AaronMichaelMendoza/Running-Watch/running watch flyer.png

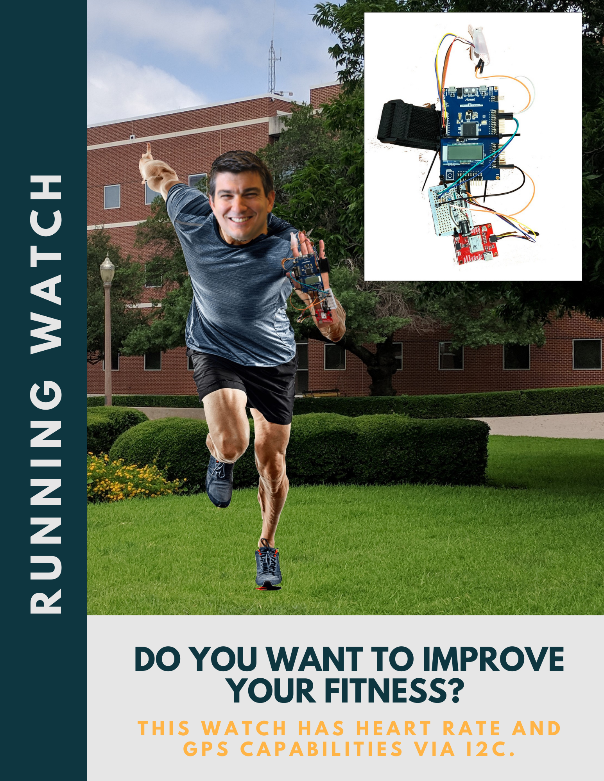
running watch flyer.png
