AaronMichaelMendoza/Running-Watch/Design/Final Project - Activity Diagram for Main.pdf

## Main

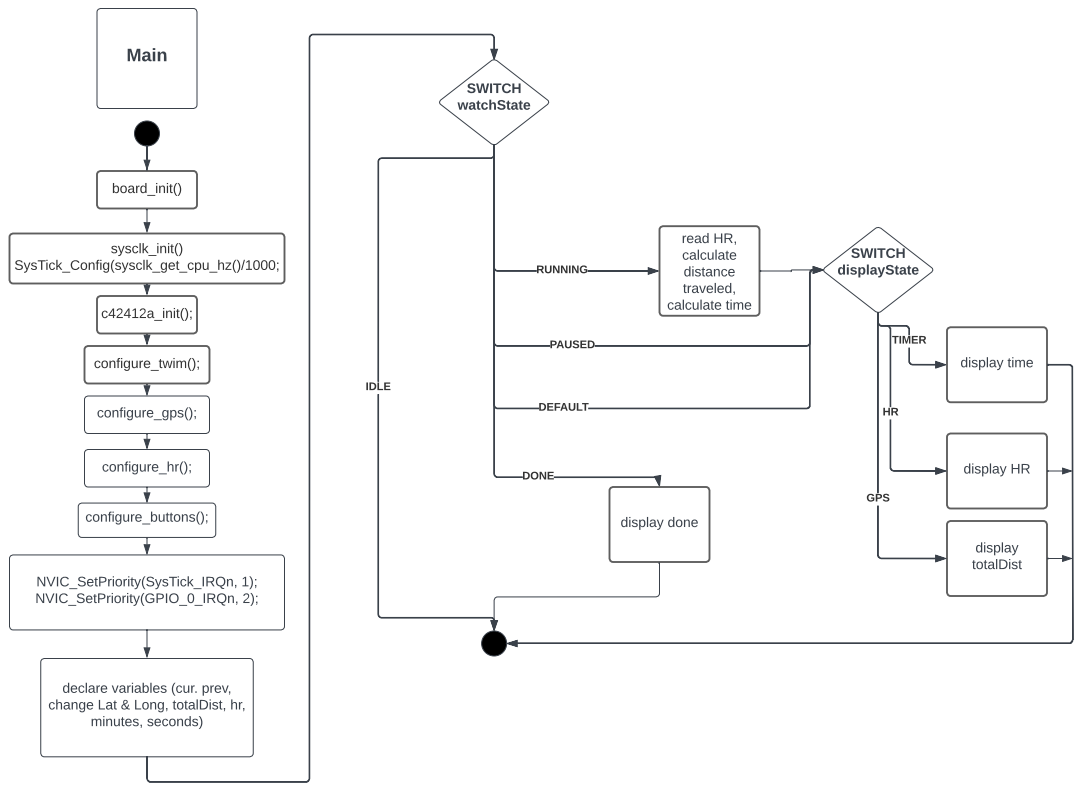
[picture p18: page 1]
configure_gps();; configure_hr();; board_init(); sysclk_init() SysTick_Config(sysclk_get_cpu_hz()/1000;; NVIC_SetPriority(SysTick_IRQn, 1); NVIC_SetPriority(GPIO_0_IRQn, 2);; c42412a_init();; configure_twim();; configure_buttons();; SWITCH watchState; IDLE; RUNNING; PAUSED; read HR, calculate distance traveled, calculate time; DONE; DEFAULT; SWITCH displayState; TIMER; display time; display HR; display totalDist; GPS; display done

declare variables (cur. prev,
change Lat & Long, totalDist, hr, minutes, seconds)
