AaronMichaelMendoza/Running-Watch/Design/Final Project - Block Diagram.pdf

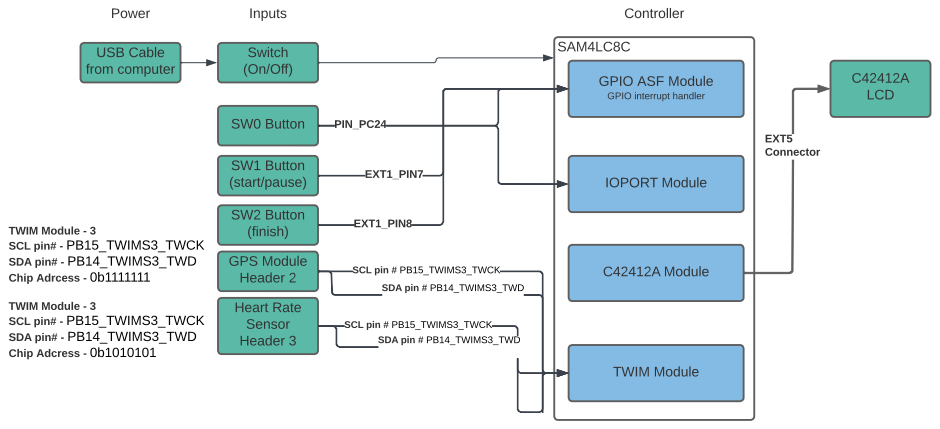
[picture p19: page 1]
Inputs; GPS Module Header 2; Heart Rate Sensor Header 3; SW0 Button; SW2 Button (finish); SW1 Button (start/pause); Switch (On/Off); Power; USB Cable from computer; Controller; SAM4LC8C; IOPORT Module; C42412A Module; TWIM Module; C42412A LCD; EXT5 Connector; PIN_PC24; EXT1_PIN7; EXT1_PIN8; TWIM Module - 3 SCL pin# - PB15_TWIMS3_TWCK SDA pin# - PB14_TWIMS3_TWD Chip Adcress - 0b1010101; TWIM Module - 3 SCL pin# - PB15_TWIMS3_TWCK SDA pin# - PB14_TWIMS3_TWD Chip Adrcess - 0b1111111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

GPIO ASF Module
GPIO interrupt handler
