AaronMichaelMendoza/Running-Watch/Design/Final Project - Callback Activity Diagrams.pdf

## button1_callback

## button2_callback

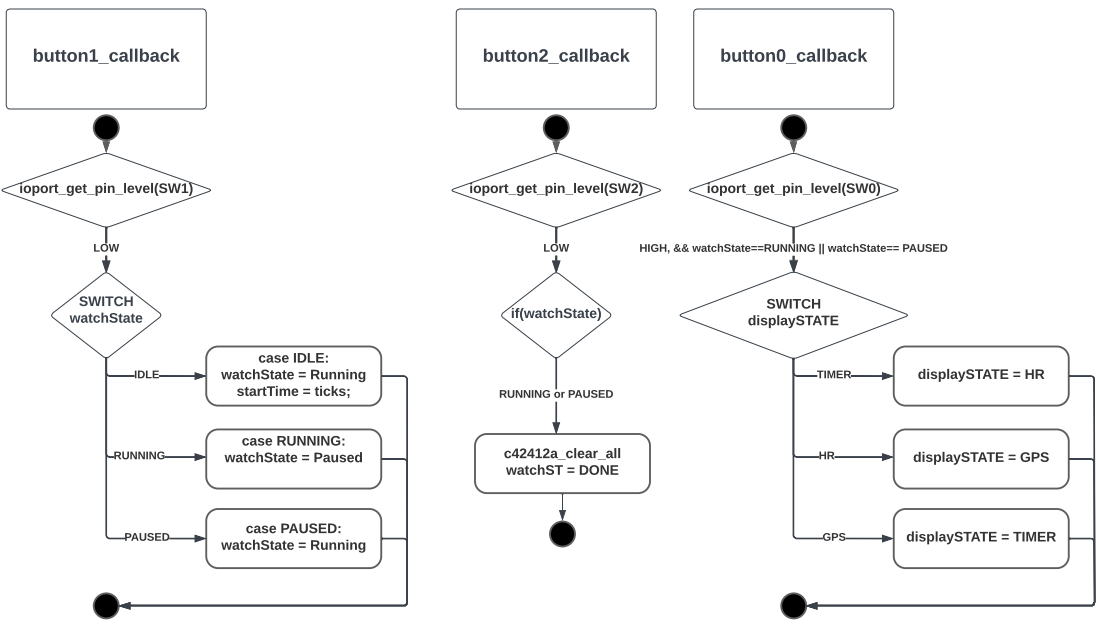
[picture p20: page 1]
SWITCH watchState; case IDLE: watchState = Running startTime = ticks;; case RUNNING: watchState = Paused; IDLE; RUNNING; case PAUSED: watchState = Running; PAUSED; ioport_get_pin_level(SW1); LOW; if(watchState); c42412a_clear_all watchST = DONE; ioport_get_pin_level(SW2); button0_callback; SWITCH displaySTATE; displaySTATE = HR; displaySTATE = GPS; TIMER; GPS; displaySTATE = TIMER; ioport_get_pin_level(SW0)

HIGH, && watchState==RUNNING || watchState== PAUSED

RUNNING or PAUSED
