AaronMichaelMendoza/Running-Watch/Design/Final Project - Configure Button Activity.pdf

## configure_Buttons

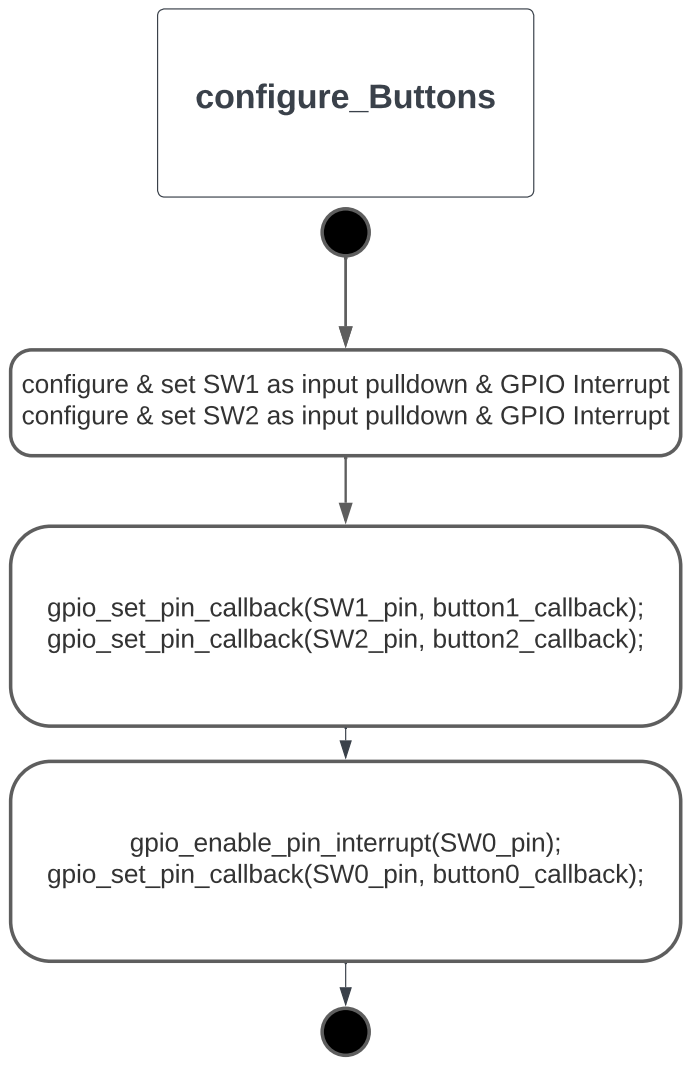
[picture p21: page 1]
gpio_set_pin_callback(SW1_pin, button1_callback); gpio_set_pin_callback(SW2_pin, button2_callback);; gpio_enable_pin_interrupt(SW0_pin); gpio_set_pin_callback(SW0_pin, button0_callback);

configure & set SW1 as input pulldown & GPIO Interrupt
configure & set SW2 as input pulldown & GPIO Interrupt
