AaronMichaelMendoza/Running-Watch/Design/Final Project - Display State Diagram.pdf

## Display State Diagram

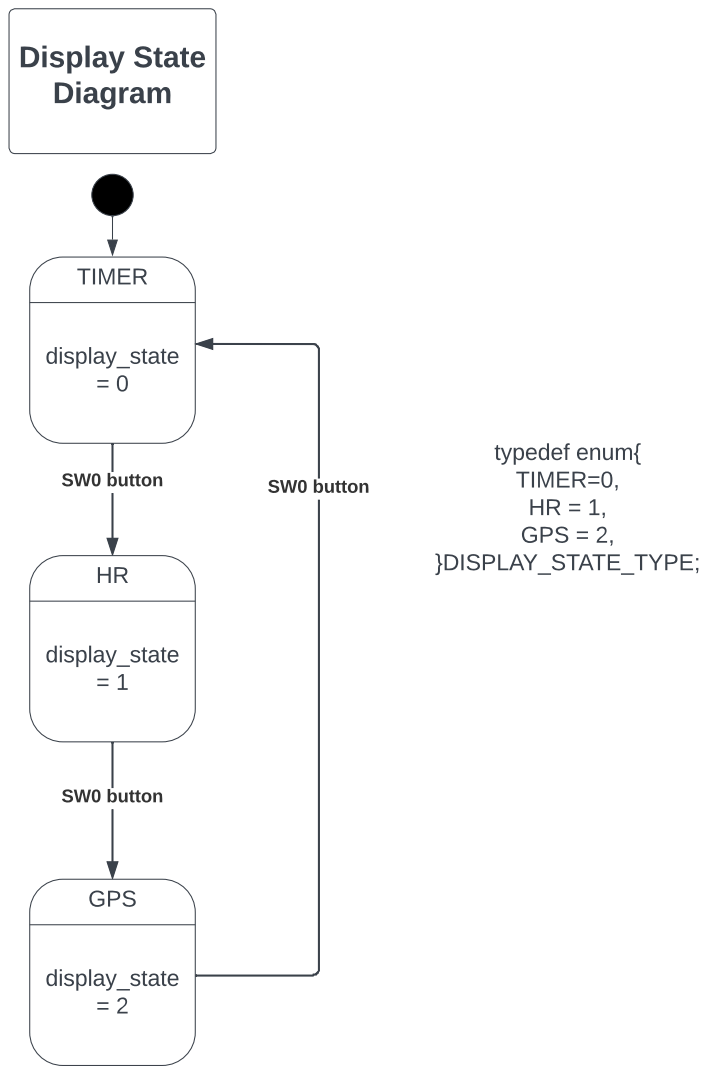
[picture p22: page 1]
TIMER; display_state = 0; SW0 button; }DISPLAY_STATE_TYPE; HR; display_state = 1; GPS; display_state = 2

typedef enum{
TIMER=0, HR = 1, GPS = 2,
