AaronMichaelMendoza/Running-Watch/Design/Final Project - Watch State Diagram.pdf

## Watch State Diagram

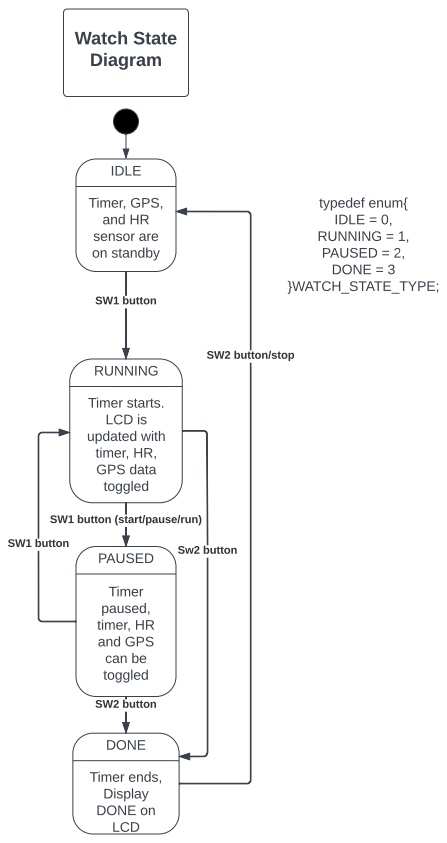
[picture p23: page 1]
IDLE; Timer, GPS, and HR sensor are on standby; RUNNING; toggled; PAUSED; Timer paused, timer, HR and GPS can be toggled; SW1 button; DONE; Timer ends, Display DONE on LCD; SW2 button; SW2 button/stop; Sw2 button; typedef enum{ IDLE = 0, RUNNING = 1,; PAUSED = 2, DONE = 3; }WATCH_STATE_TYPE;

Timer starts.
LCD is
updated with
timer, HR, GPS data

SW1 button (start/pause/run)
