AaronMichaelMendoza/Running-Watch/Design/Updated Project Schematic.pdf

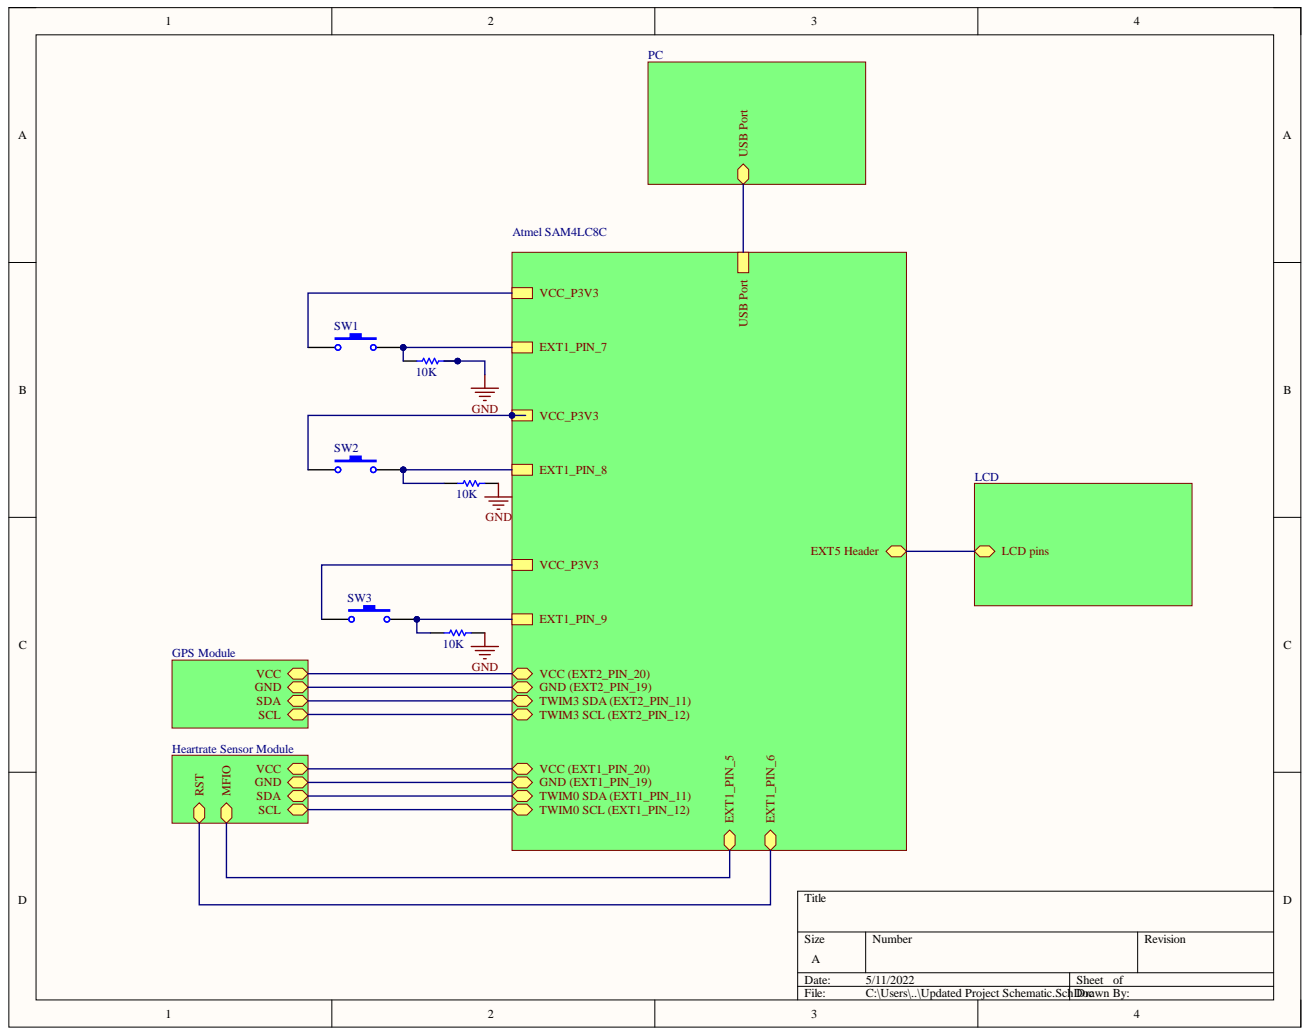
[picture p24: page 1]
