AaronMichaelMendoza/Running-Watch/(list of files, drawings)

Other design files:
Design/Updated Project Schematic.SchDoc
