AaronMichaelMendoza/Running-Watch/Software/Embedded_Lab_Shively/Embedded_Lab_Shively/Embedded_Lab_Shively/src/config/conf_board.h

/**
 * \file
 *
 * \brief Board configuration.
 *
 * Copyright (c) 2012-2018 Microchip Technology Inc. and its subsidiaries.
 *
 * \asf_license_start
 *
 * \page License
 *
 * Subject to your compliance with these terms, you may use Microchip
 * software and any derivatives exclusively with Microchip products.
 * It is your responsibility to comply with third party license terms applicable
 * to your use of third party software (including open source software) that
 * may accompany Microchip software.
 *
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
 * \asf_license_stop
 *
 */
/*
 * Support and FAQ: visit <a href="https://www.microchip.com/support/">Microchip Support</a>
 */

#ifndef CONF_BOARD_H_INCLUDED
#define CONF_BOARD_H_INCLUDED

/** Enable Com Port. */
#define CONF_BOARD_UART_CONSOLE

// define EIC pin
//#define CONF_BOARD_EIC

// define TWIM pins
#define CONF_BOARD_TWIMS3
#define CONF_BOARD_TWIMS0



// define COM port
#define CONF_BOARD_COM_PORT

//! [tc_define_peripheral]
/* Use TC Peripheral 0. */
#define TC             TC0
#define TC_PERIPHERAL  0
//! [tc_define_peripheral]

//! [tc_define_ch1]
/* Configure TC0 channel 1 as waveform output. */
#define TC_CHANNEL_WAVEFORM 1
#define ID_TC_WAVEFORM      ID_TC1
#define PIN_TC_WAVEFORM     PIN_TC0_TIOA1
#define PIN_TC_WAVEFORM_MUX PIN_TC0_TIOA1_MUX
//! [tc_define_ch1]

//! [tc_define_ch2]
/* Configure TC0 channel 2 as capture input. */
#define TC_CHANNEL_CAPTURE 2
#define ID_TC_CAPTURE ID_TC2
#define PIN_TC_CAPTURE PIN_TC0_TIOA2
#define PIN_TC_CAPTURE_MUX PIN_TC0_TIOA2_MUX
//! [tc_define_ch2]

//! [tc_define_irq_handler]
/* Use TC2_Handler for TC capture interrupt. */
#define TC_Handler  TC2_Handler
#define TC_IRQn     TC2_IRQn
//! [tc_define_irq_handler]

#endif /* CONF_BOARD_H_INCLUDED */
