AaronMichaelMendoza/Running-Watch/Hardware/Finger Clip.jpeg

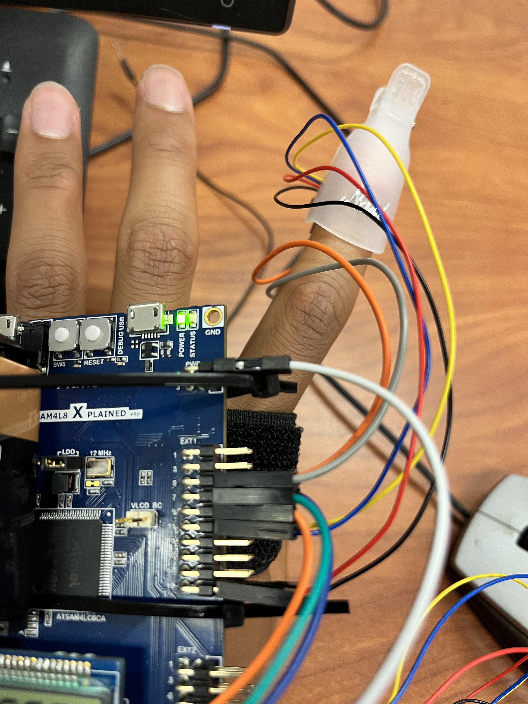
Hardware/Finger Clip.jpeg
