AaronMichaelMendoza/Running-Watch/Hardware/HR Connections.jpeg

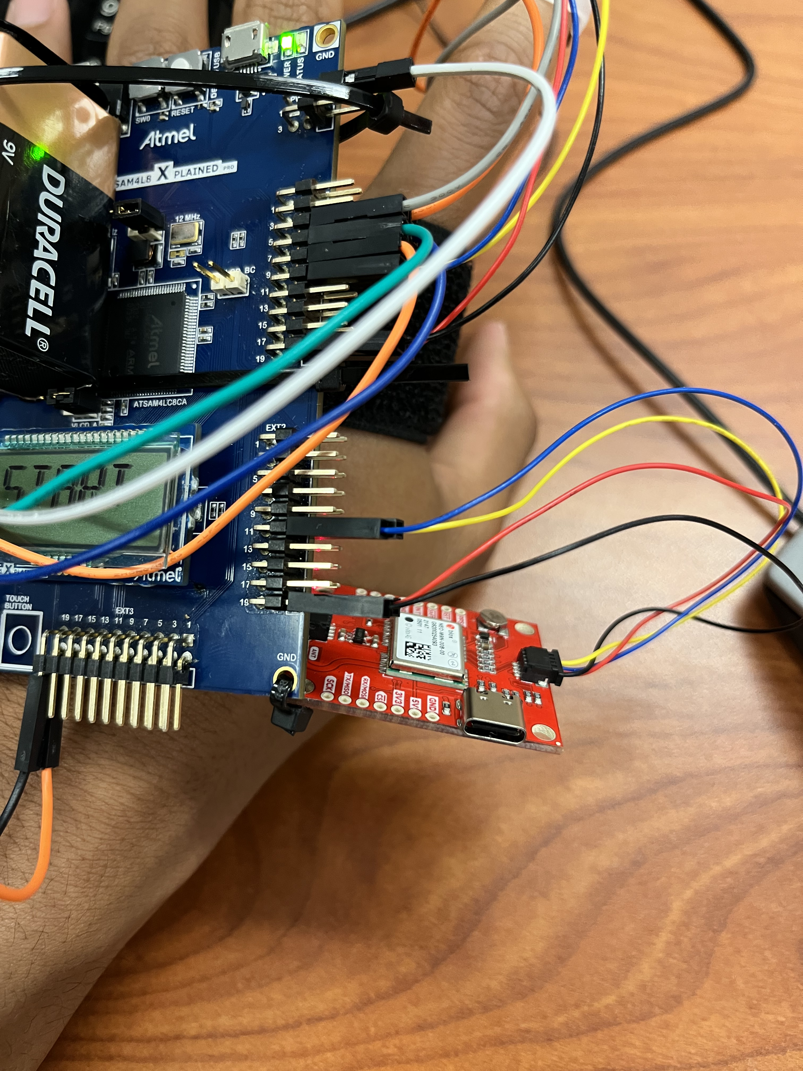
Hardware/HR Connections.jpeg
